samycharas/demoboard/DemoBoard.brd

## EAGLE design DemoBoard.brd (2022-02-07)

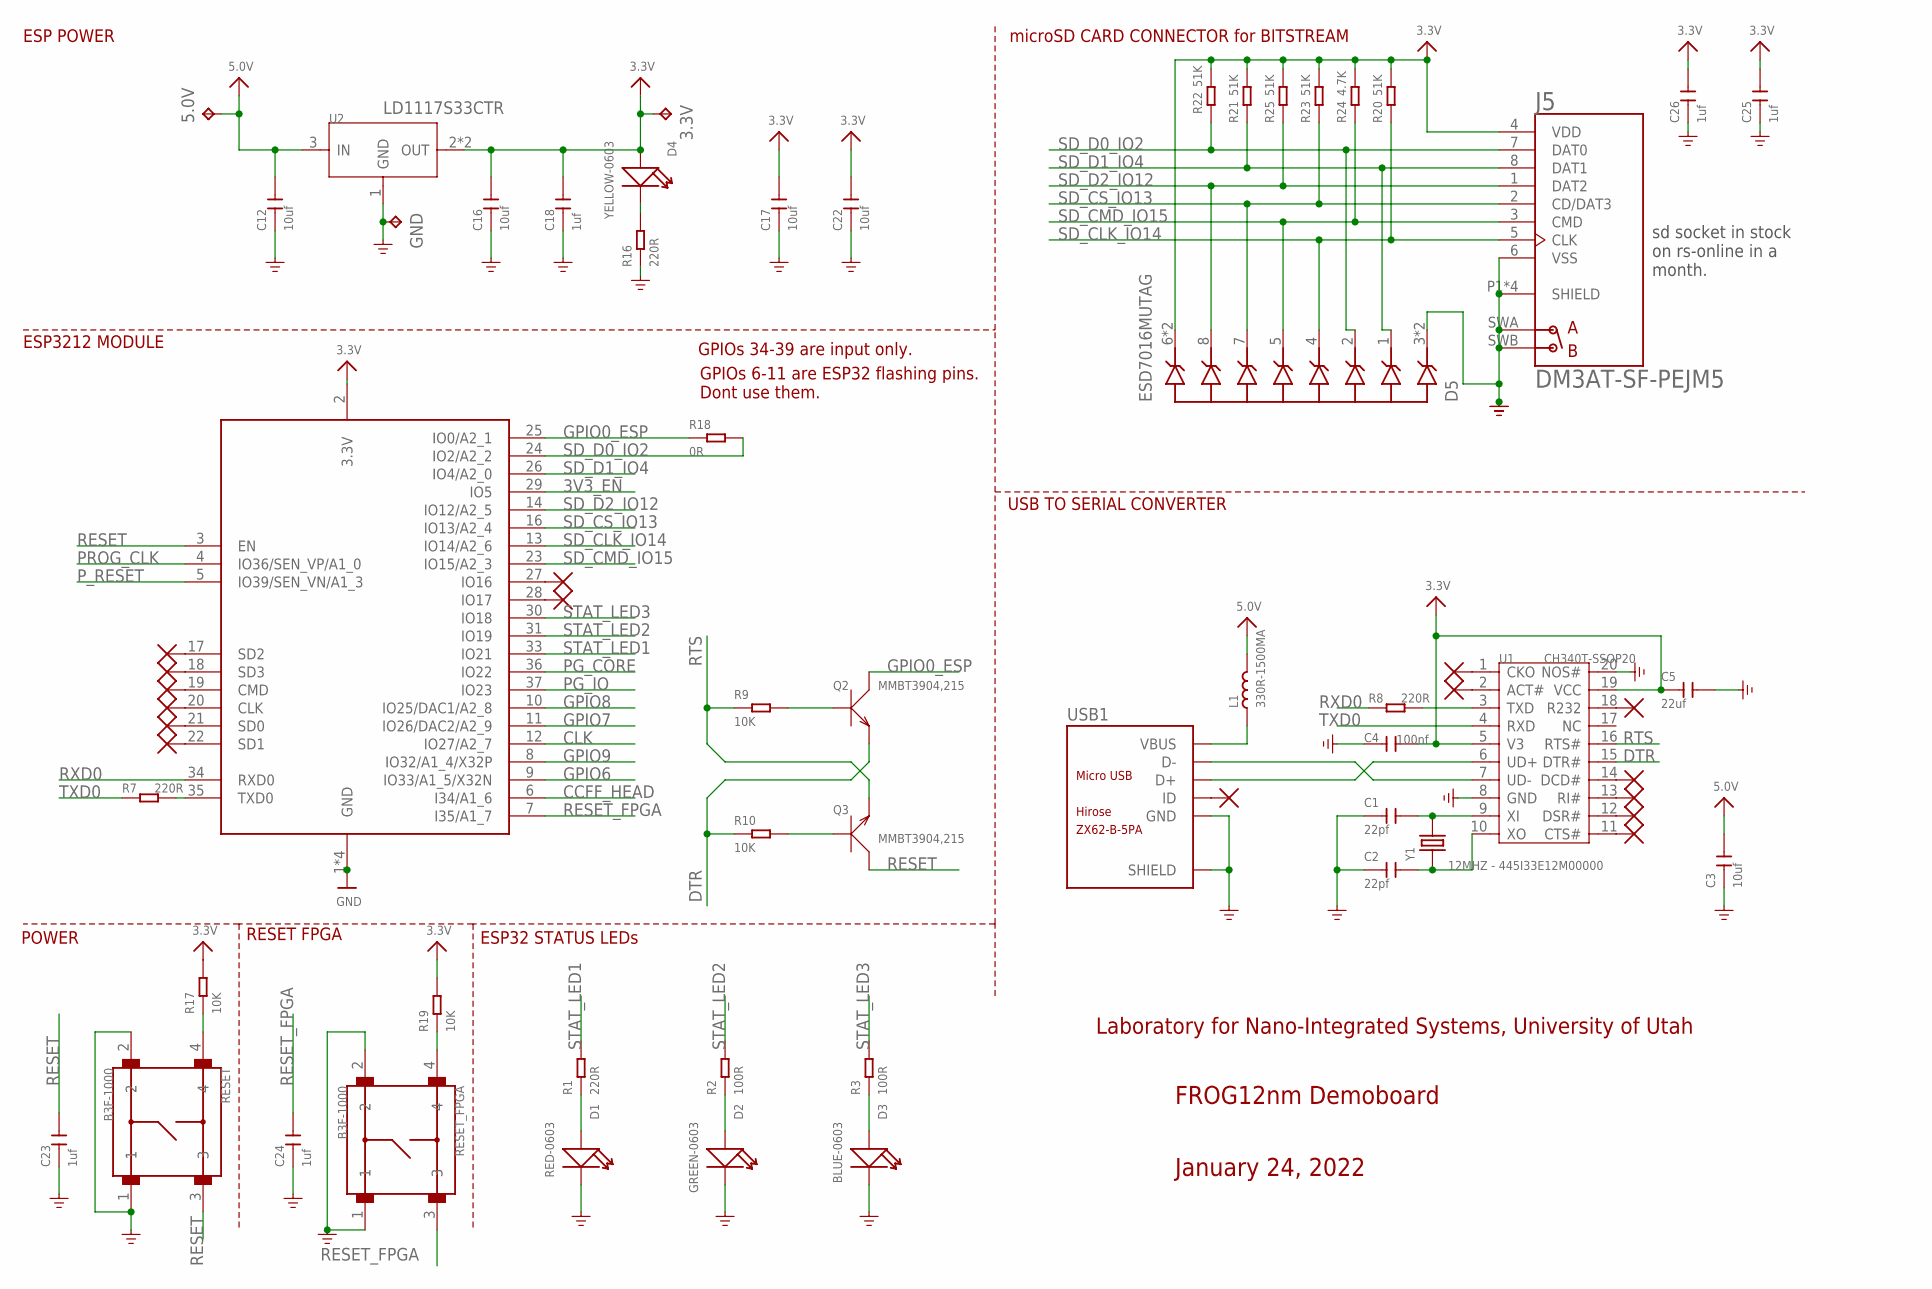
[picture p1: schematic DemoBoard.sch, sheet 1]

Parts:
3.3V, 5.0V: TPTP20SQ; TP20SQ
C1, C2: 22pf; C0603
C3, C12, C16, C17, C22: 10uf; C0603
C4: 100nf; C0603
C5: 22uf; C0805
C18, C23, C24, C25, C26: 1uf; C0603
D1: RED-0603; LED-0603
D2: GREEN-0603; LED-0603
D3: BLUE-0603; LED-0603
D4: YELLOW-0603; LED-0603
D5: ESD7016MUTAG; TVS_ESD7016MUTAG
GND: TPTP20SQ; TP20SQ
J5: DM3AT-SF-PEJM5; HRS_DM3AT-SF-PEJM5
L1: 330R-1500MA; L0805
Q2, Q3: MMBT3904,215; SOT-23
R1, R7, R8, R16: 220R; R0603
R2, R3: 100R; R0603
R9, R10, R17, R19: 10K; R0603
R18: 0R; R0603
R20, R21, R22, R23, R25: 51K; R0603
R24: 4.7K; R0603
RESET: B3F-1000; SW_B3F-1000
RESET_FPGA: B3F-1000; SW_B3F-1000
U1: CH340T-SSOP20; SSOP20-0.65-7.6X5.2MM
U2: PMIC-CJT1117-3.3(SOT223); SOT-223; MPN LD1117S33CTR
U3: ESP32_WROOM32_SKINNY; WROOM32_SKINNY
USB1: ZX62-B-5PA; MICRO-USB5+6P-SMD-0.65-AB
Y1: 12MHZ - 445I33E12M00000; X2-SMD-5.0X3.2X1.3MM

Connections:
3.3V: 3.3V.TP, C4.2, C5.1, C16.2, C17.2, C18.2, C22.2, C25.2, C26.2, D4.+, D5.6 (GND), D5.9 (GND), J5.4 (VDD), R17.2, R19.2, R20.2, R21.2, R22.2, R23.2, R24.2, R25.2, U1.5 (V3), U1.19 (VCC), U2.2 (OUT), U2.TER (OUT), U3.2 (3.3V); also elsewhere on the board
3V3_EN: U3.29 (IO5); also elsewhere on the board
5.0V: 5.0V.TP, C3.2, C12.2, L1.2, U2.3 (IN); also elsewhere on the board
CCFF_HEAD: U3.6 (I34/A1_6); also elsewhere on the board
CLK: U3.12 (IO27/A2_7); also elsewhere on the board
DTR: Q2.2 (E), R10.1, U1.15 (DTR#)
GND: C1.1, C2.1, C3.1, C4.1, C5.2, C12.1, C16.1, C17.1, C18.1, C22.1, C23.1, C24.1, C25.1, C26.1, D1.-, D2.-, D3.-, D5.3 (VBUS), D5.10 (VBUS), GND.TP, J5.6 (VSS), J5.P1 (SHIELD), J5.P2 (SHIELD), J5.P3 (SHIELD), J5.P4 (SHIELD), J5.SWA (A), J5.SWB (B), R16.1, RESET.1, RESET.2, RESET_FPGA.1, RESET_FPGA.2, U1.8 (GND), U1.20 (NOS#), U2.1 (GND), U3.1 (GND), U3.15 (GND), U3.38 (GND), U3.P$1 (GND), USB1.5 (GND), USB1.P1 (SHIELD), USB1.P2 (SHIELD), USB1.P3_1 (SHIELD), USB1.P3_2 (SHIELD), USB1.P3_3 (SHIELD), USB1.P4_1 (SHIELD), USB1.P4_2 (SHIELD), USB1.P4_3 (SHIELD), USB1.P5 (SHIELD), USB1.P6 (SHIELD); also elsewhere on the board
GPIO0_ESP: Q2.3 (C), R18.1, U3.25 (IO0/A2_1)
GPIO6: U3.9 (IO33/A1_5/X32N); also elsewhere on the board
GPIO7: U3.11 (IO26/DAC2/A2_9); also elsewhere on the board
GPIO8: U3.10 (IO25/DAC1/A2_8); also elsewhere on the board
GPIO9: U3.8 (IO32/A1_4/X32P); also elsewhere on the board
unnamed: D2.+, R2.1
unnamed: R17.1, RESET.4
unnamed: R19.1, RESET_FPGA.4
unnamed: D1.+, R1.1
unnamed: Q3.1 (B), R10.2
unnamed: Q2.1 (B), R9.2
unnamed: D3.+, R3.1
unnamed: D4.-, R16.2
unnamed: U1.7 (UD-), USB1.2 (D-)
unnamed: U1.6 (UD+), USB1.3 (D+)
unnamed: C1.2, U1.9 (XI), Y1.2
unnamed: C2.2, U1.10 (XO), Y1.1
unnamed: R8.2, U1.3 (TXD)
unnamed: R7.2, U3.35 (TXD0)
PG_CORE: U3.36 (IO22); also elsewhere on the board
PG_IO: U3.37 (IO23); also elsewhere on the board
PROG_CLK: U3.4 (IO36/SEN_VP/A1_0); also elsewhere on the board
P_RESET: U3.5 (IO39/SEN_VN/A1_3); also elsewhere on the board
RESET: C23.2, Q3.3 (C), RESET.3, U3.3 (EN)
RESET_FPGA: C24.2, RESET_FPGA.3, U3.7 (I35/A1_7); also elsewhere on the board
RTS: Q3.2 (E), R9.1, U1.16 (RTS#)
RXD0: R8.1, U3.34 (RXD0)
SD_CLK_IO14: D5.4 (I/O3), J5.5 (CLK), R20.1, U3.13 (IO14/A2_6)
SD_CMD_IO15: D5.5 (I/O4), J5.3 (CMD), R24.1, U3.23 (IO15/A2_3)
SD_CS_IO13: D5.7 (I/O5), J5.2 (CD/DAT3), R23.1, U3.16 (IO13/A2_4)
SD_D0_IO2: D5.2 (I/O2), J5.7 (DAT0), R18.2, R22.1, U3.24 (IO2/A2_2)
SD_D1_IO4: D5.1 (I/O1), J5.8 (DAT1), R21.1, U3.26 (IO4/A2_0)
SD_D2_IO12: D5.8 (I/O6), J5.1 (DAT2), R25.1, U3.14 (IO12/A2_5)
STAT_LED1: R1.2, U3.33 (IO21)
STAT_LED2: R2.2, U3.31 (IO19)
STAT_LED3: R3.2, U3.30 (IO18)
TXD0: R7.1, U1.4 (RXD)
VBUS: L1.1, USB1.1 (VBUS)

Notes on the sheet:
ESP POWER
RESET FPGA
USB TO SERIAL CONVERTER
ESP3212 MODULE
POWER
microSD CARD CONNECTOR for BITSTREAM
FROG12nm Demoboard
January 24, 2022
ESP32 STATUS LEDs
GPIOs 34-39 are input only.
Laboratory for Nano-Integrated Systems, University of Utah
GPIOs 6-11 are ESP32 flashing pins. Dont use them.
sd socket in stock on rs-online in a month.

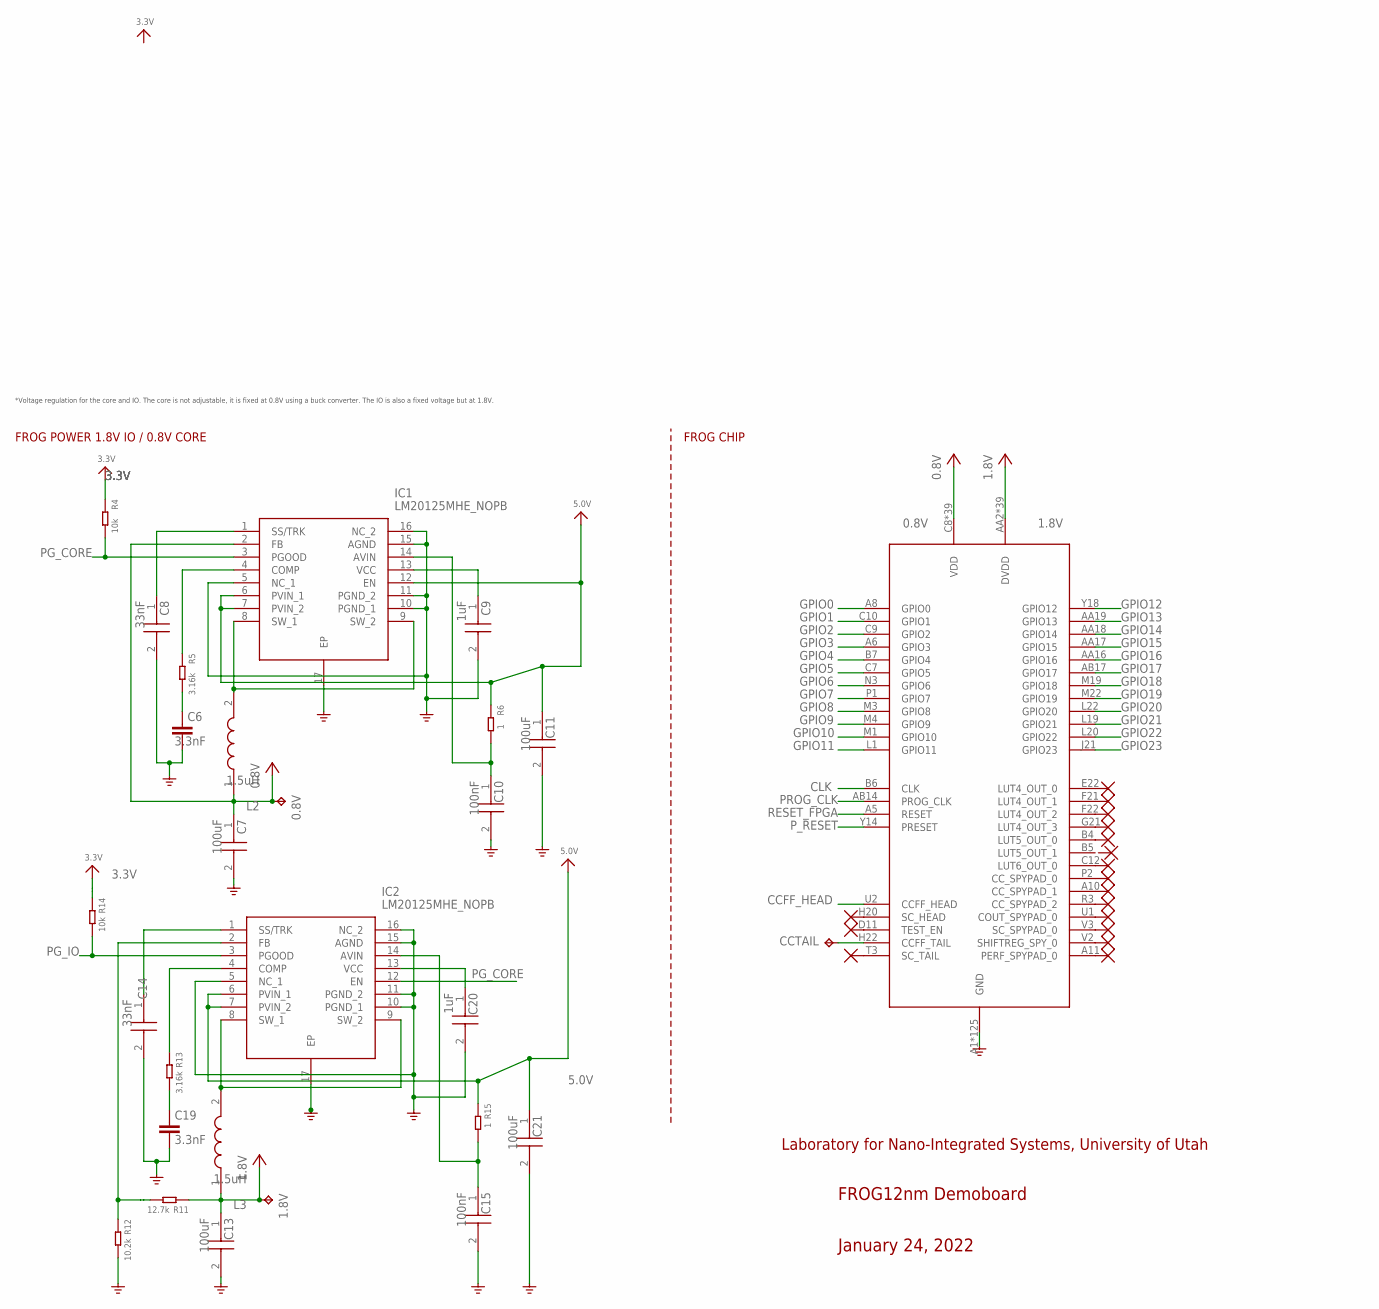
[picture p2: schematic DemoBoard.sch, sheet 2]

Parts:
0.8V, 1.8V: TPTP20SQ; TP20SQ
C6, C19: 3.3nF; CAPC1608X85
C7, C11, C13, C21: 100uF; CAPC3225X270N
C8, C14: 33nF; CAPC1608X97N
C9, C20: 1uF; CAPC1005X55N
C10, C15: 100nF; CAPC1005X55N
CCTAIL: TPPAD1-13; P1-13
IC1, IC2: LM20125MHE_NOPB; SOP65P640X120-17N
L2, L3: 1.5uH; INDPM7066X300N
R4, R14: 10k; R0603
R5, R13: 3.16k; R0603
R6, R15: 1; R0603
R11: 12.7k; R0603
R12: 10.2k; R0603
U4: FROG12NM; BGA484C100P22X22_2400X2400X220N

Connections:
0.8V: 0.8V.TP, C7.1, IC1.2 (FB), L2.1, U4.C8 (VDD), U4.D4 (VDD), U4.D5 (VDD), U4.D7 (VDD), U4.D8 (VDD), U4.D15 (VDD), U4.D16 (VDD), U4.D19 (VDD), U4.E19 (VDD), U4.H9 (VDD), U4.H10 (VDD), U4.H11 (VDD), U4.H12 (VDD), U4.H13 (VDD), U4.H14 (VDD), U4.J8 (VDD), U4.J15 (VDD), U4.K8 (VDD), U4.K15 (VDD), U4.L8 (VDD), U4.L15 (VDD), U4.M8 (VDD), U4.M15 (VDD), U4.N8 (VDD), U4.N15 (VDD), U4.P8 (VDD), U4.P15 (VDD), U4.R9 (VDD), U4.R10 (VDD), U4.R11 (VDD), U4.R12 (VDD), U4.R13 (VDD), U4.R14 (VDD), U4.W4 (VDD), U4.W5 (VDD), U4.W8 (VDD), U4.W15 (VDD), U4.W18 (VDD), U4.W19 (VDD)
1.8V: 1.8V.TP, C13.1, L3.1, R11.1, U4.AA2 (DVDD), U4.AA9 (DVDD), U4.AA14 (DVDD), U4.AA21 (DVDD), U4.AB5 (DVDD), U4.AB18 (DVDD), U4.B2 (DVDD), U4.B9 (DVDD), U4.B12 (DVDD), U4.B15 (DVDD), U4.B20 (DVDD), U4.B21 (DVDD), U4.C4 (DVDD), U4.C6 (DVDD), U4.C11 (DVDD), U4.C17 (DVDD), U4.D20 (DVDD), U4.E20 (DVDD), U4.F3 (DVDD), U4.F20 (DVDD), U4.G3 (DVDD), U4.G20 (DVDD), U4.H4 (DVDD), U4.H19 (DVDD), U4.N2 (DVDD), U4.N21 (DVDD), U4.R4 (DVDD), U4.R19 (DVDD), U4.R20 (DVDD), U4.T4 (DVDD), U4.U3 (DVDD), U4.U20 (DVDD), U4.U21 (DVDD), U4.V1 (DVDD), U4.V21 (DVDD), U4.V22 (DVDD), U4.Y6 (DVDD), U4.Y16 (DVDD), U4.Y17 (DVDD)
3.3V: R4.1, R14.1; also elsewhere on the board
5.0V: C11.1, C21.1, IC1.6 (PVIN_1), IC1.7 (PVIN_2), IC1.12 (EN), IC2.6 (PVIN_1), IC2.7 (PVIN_2), R6.1, R15.1; also elsewhere on the board
CCFF_HEAD: U4.U2 (CCFF_HEAD); also elsewhere on the board
CLK: U4.B6 (CLK); also elsewhere on the board
GND: C6.2, C7.2, C8.2, C9.2, C10.2, C11.2, C13.2, C14.2, C15.2, C19.2, C20.2, C21.2, IC1.5 (NC_1), IC1.10 (PGND_1), IC1.11 (PGND_2), IC1.15 (AGND), IC1.16 (NC_2), IC1.17 (EP), IC2.5 (NC_1), IC2.10 (PGND_1), IC2.11 (PGND_2), IC2.15 (AGND), IC2.16 (NC_2), IC2.17 (EP), R12.2, U4.A1 (GND), U4.A4 (GND), U4.A9 (GND), U4.A12 (GND), U4.A15 (GND), U4.A19 (GND), U4.A22 (GND), U4.AA3 (GND), U4.AA10 (GND), U4.AA13 (GND), U4.AA20 (GND), U4.AB1 (GND), U4.AB4 (GND), U4.AB7 (GND), U4.AB10 (GND), U4.AB13 (GND), U4.AB16 (GND), U4.AB19 (GND), U4.AB22 (GND), U4.B3 (GND), U4.B10 (GND), U4.B11 (GND), U4.B13 (GND), U4.B14 (GND), U4.C2 (GND), U4.C3 (GND), U4.C13 (GND), U4.C14 (GND), U4.C20 (GND), U4.C21 (GND), U4.D1 (GND), U4.D3 (GND), U4.D6 (GND), U4.D9 (GND), U4.D10 (GND), U4.D14 (GND), U4.D17 (GND), U4.D18 (GND), U4.D21 (GND), U4.D22 (GND), U4.E4 (GND), U4.F4 (GND), U4.F19 (GND), U4.G1 (GND), U4.G4 (GND), U4.G19 (GND), U4.G22 (GND), U4.H8 (GND), U4.H15 (GND), U4.J4 (GND), U4.J9 (GND), U4.J10 (GND), U4.J11 (GND), U4.J12 (GND), U4.J13 (GND), U4.J14 (GND), U4.K1 (GND), U4.K4 (GND), U4.K9 (GND), U4.K10 (GND), U4.K11 (GND), U4.K12 (GND), U4.K13 (GND), U4.K14 (GND), U4.K19 (GND), U4.K22 (GND), U4.L2 (GND), U4.L4 (GND), U4.L9 (GND), U4.L10 (GND), U4.L11 (GND), U4.L12 (GND), U4.L13 (GND), U4.L14 (GND), U4.L21 (GND), U4.M2 (GND), U4.M9 (GND), U4.M10 (GND), U4.M11 (GND), U4.M12 (GND), U4.M13 (GND), U4.M14 (GND), U4.M20 (GND), U4.M21 (GND), U4.N1 (GND), U4.N4 (GND), U4.N9 (GND), U4.N10 (GND), U4.N11 (GND), U4.N12 (GND), U4.N13 (GND), U4.N14 (GND), U4.N19 (GND), U4.N22 (GND), U4.P9 (GND), U4.P10 (GND), U4.P11 (GND), U4.P12 (GND), U4.P13 (GND), U4.P14 (GND), U4.R2 (GND), U4.R8 (GND), U4.R15 (GND), U4.T1 (GND), U4.T2 (GND), U4.T19 (GND), U4.T22 (GND), U4.U4 (GND), U4.U19 (GND), U4.V4 (GND), U4.V19 (GND), U4.W1 (GND), U4.W2 (GND), U4.W6 (GND), U4.W7 (GND), U4.W10 (GND), U4.W13 (GND), U4.W16 (GND), U4.W17 (GND), U4.W22 (GND), U4.Y2 (GND), U4.Y3 (GND), U4.Y10 (GND), U4.Y13 (GND), U4.Y20 (GND); also elsewhere on the board
GPIO0: U4.A8 (GPIO0); also elsewhere on the board
GPIO1: U4.C10 (GPIO1); also elsewhere on the board
GPIO2: U4.C9 (GPIO2); also elsewhere on the board
GPIO3: U4.A6 (GPIO3); also elsewhere on the board
GPIO4: U4.B7 (GPIO4); also elsewhere on the board
GPIO5: U4.C7 (GPIO5); also elsewhere on the board
GPIO6: U4.N3 (GPIO6); also elsewhere on the board
GPIO7: U4.P1 (GPIO7); also elsewhere on the board
GPIO8: U4.M3 (GPIO8); also elsewhere on the board
GPIO9: U4.M4 (GPIO9); also elsewhere on the board
GPIO10: U4.M1 (GPIO10); also elsewhere on the board
GPIO11: U4.L1 (GPIO11); also elsewhere on the board
GPIO12: U4.Y18 (GPIO12); also elsewhere on the board
GPIO13: U4.AA19 (GPIO13); also elsewhere on the board
GPIO14: U4.AA18 (GPIO14); also elsewhere on the board
GPIO15: U4.AA17 (GPIO15); also elsewhere on the board
GPIO16: U4.AA16 (GPIO16); also elsewhere on the board
GPIO17: U4.AB17 (GPIO17); also elsewhere on the board
GPIO18: U4.M19 (GPIO18); also elsewhere on the board
GPIO19: U4.M22 (GPIO19); also elsewhere on the board
GPIO20: U4.L22 (GPIO20); also elsewhere on the board
GPIO21: U4.L19 (GPIO21); also elsewhere on the board
GPIO22: U4.L20 (GPIO22); also elsewhere on the board
GPIO23: U4.J21 (GPIO23); also elsewhere on the board
unnamed: IC1.4 (COMP), R5.1
unnamed: C6.1, R5.2
unnamed: C9.1, IC1.13 (VCC)
unnamed: C8.1, IC1.1 (SS/TRK)
unnamed: IC1.8 (SW_1), IC1.9 (SW_2), L2.2
unnamed: CCTAIL.TP, U4.H22 (CCFF_TAIL)
unnamed: C10.1, IC1.14 (AVIN), R6.2
unnamed: IC2.4 (COMP), R13.1
unnamed: C19.1, R13.2
unnamed: C20.1, IC2.13 (VCC)
unnamed: C14.1, IC2.1 (SS/TRK)
unnamed: IC2.8 (SW_1), IC2.9 (SW_2), L3.2
unnamed: C15.1, IC2.14 (AVIN), R15.2
PG_CORE: IC1.3 (PGOOD), IC2.12 (EN), R4.2; also elsewhere on the board
PG_IO: IC2.3 (PGOOD), R14.2; also elsewhere on the board
PROG_CLK: U4.AB14 (PROG_CLK); also elsewhere on the board
P_RESET: U4.Y14 (PRESET); also elsewhere on the board
RESET_FPGA: U4.A5 (RESET); also elsewhere on the board
VDD_CORE: IC2.2 (FB), R11.2, R12.1

Notes on the sheet:
FROG12nm Demoboard
January 24, 2022
Laboratory for Nano-Integrated Systems, University of Utah
*Voltage regulation for the core and IO. The core is not adjustable, it is fixed at 0.8V using a buck converter. The IO is also a fixed voltage but at 1.8V.
FROG POWER 1.8V IO / 0.8V CORE
FROG CHIP

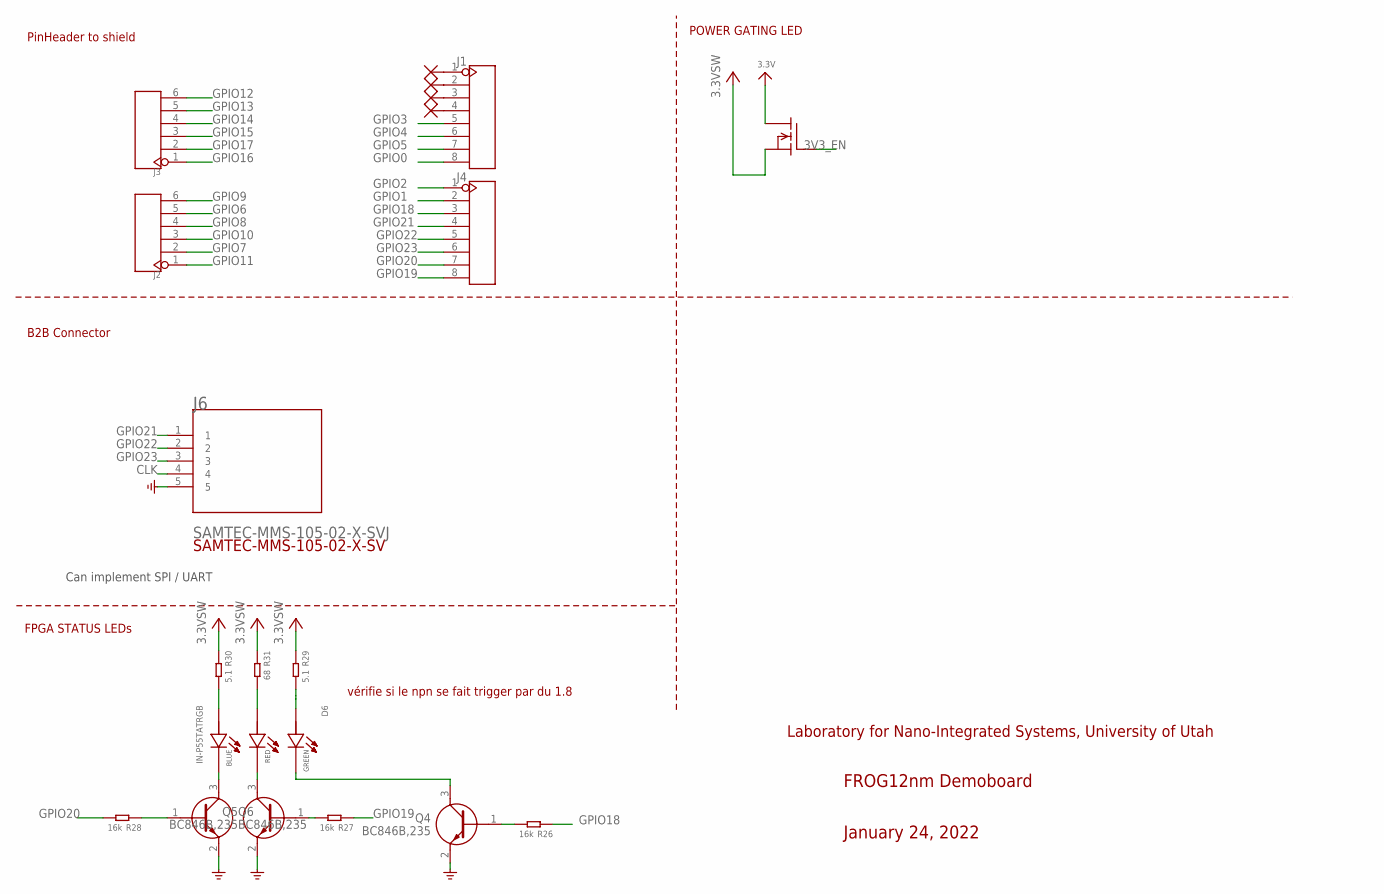
[picture p3: schematic DemoBoard.sch, sheet 3]

Parts:
D6: IN-P55TATRGB; LED_IN-P55TATRGB
J1, J4: HEADER-8P-2.54; 8P-2.54
J2, J3: HEADER-6P-55/35MIL; 6P-2.54-55/35MIL
J6: SAMTEC-MMS-105-02-X-SVJ; SAMTEC-MMS-105-02-X-SV
Q1: IRLML0030TRPBF; SOT23
Q4, Q5, Q6: BC846B,235; SOT95P230X110-3N
R26, R27, R28: 16k; R0603
R29, R30: 5.1; R0603
R31: 68; R0603

Connections:
3.3V: Q1.3 (D); also elsewhere on the board
3.3VSW: Q1.2 (S), R29.1, R30.1, R31.1
3V3_EN: Q1.1 (G); also elsewhere on the board
CLK: J6.4; also elsewhere on the board
GND: J6.5, Q4.2 (E), Q5.2 (E), Q6.2 (E); also elsewhere on the board
GPIO0: J1.8; also elsewhere on the board
GPIO1: J4.2; also elsewhere on the board
GPIO2: J4.1; also elsewhere on the board
GPIO3: J1.5; also elsewhere on the board
GPIO4: J1.6; also elsewhere on the board
GPIO5: J1.7; also elsewhere on the board
GPIO6: J2.5; also elsewhere on the board
GPIO7: J2.2; also elsewhere on the board
GPIO8: J2.4; also elsewhere on the board
GPIO9: J2.6; also elsewhere on the board
GPIO10: J2.3; also elsewhere on the board
GPIO11: J2.1; also elsewhere on the board
GPIO12: J3.6; also elsewhere on the board
GPIO13: J3.5; also elsewhere on the board
GPIO14: J3.4; also elsewhere on the board
GPIO15: J3.3; also elsewhere on the board
GPIO16: J3.1; also elsewhere on the board
GPIO17: J3.2; also elsewhere on the board
GPIO18: J4.3, R26.1; also elsewhere on the board
GPIO19: J4.8, R27.1; also elsewhere on the board
GPIO20: J4.7, R28.2; also elsewhere on the board
GPIO21: J4.4, J6.1; also elsewhere on the board
GPIO22: J4.5, J6.2; also elsewhere on the board
GPIO23: J4.6, J6.3; also elsewhere on the board
unnamed: D6.1 (B_C), Q6.3 (C)
unnamed: Q5.1 (B), R27.2
unnamed: D6.2 (R_C), Q5.3 (C)
unnamed: D6.3 (G_C), Q4.3 (C)
unnamed: Q6.1 (B), R28.1
unnamed: Q4.1 (B), R26.2
unnamed: D6.5 (R_A), R31.2
VCC2: D6.4 (G_A), D6.6 (B_A), R29.2, R30.2

Notes on the sheet:
FROG12nm Demoboard
January 24, 2022
Laboratory for Nano-Integrated Systems, University of Utah
B2B Connector
Can implement SPI / UART
PinHeader to shield
FPGA STATUS LEDs
vérifie si le npn se fait trigger par du 1.8
POWER GATING LED

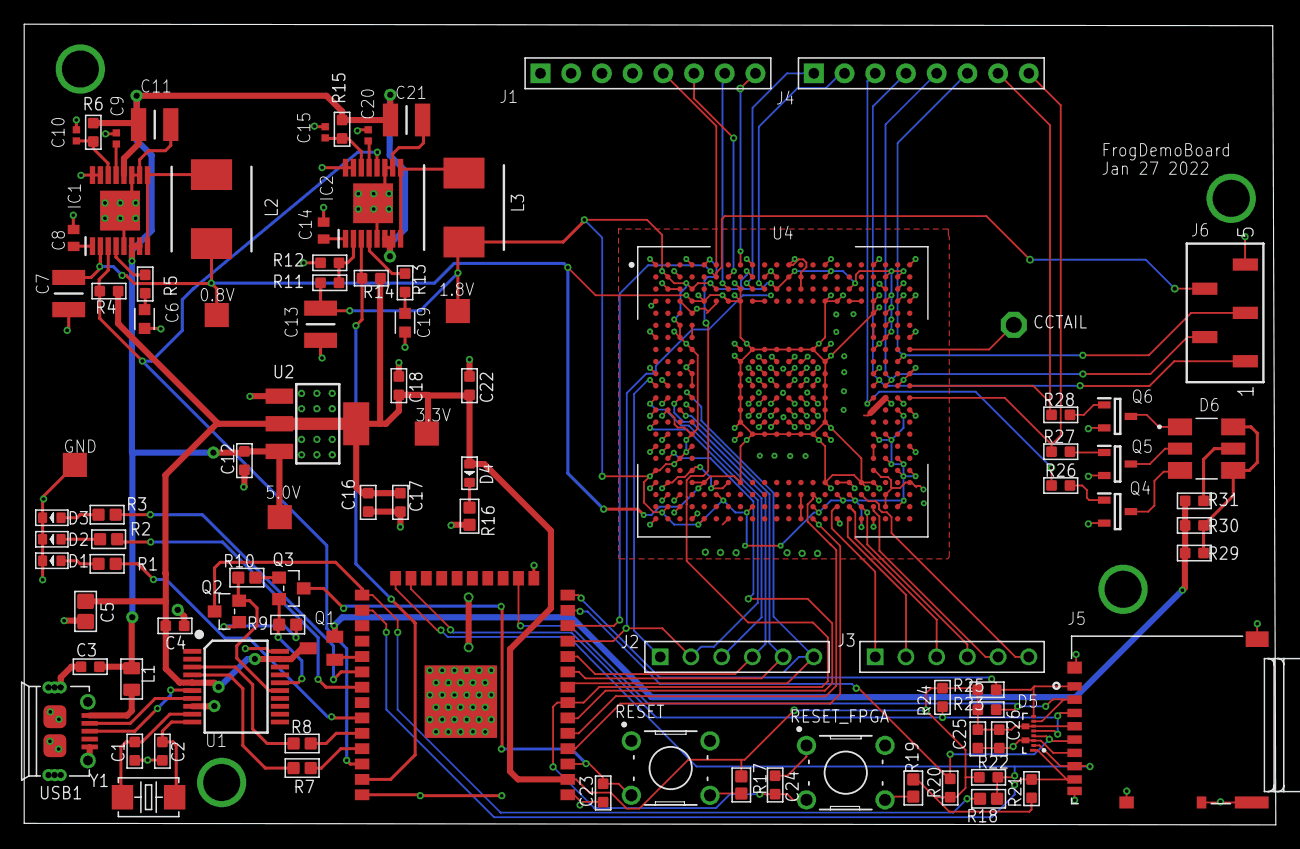
[picture p4: board DemoBoard.brd from above]

Board: 2 copper layers, 103.5 x 66.2 mm, 94 parts (0 on the bottom side), 90 nets.
