samycharas/demoboard/project/DemoBoard.brd

## EAGLE design project/DemoBoard.brd (2020-08-27, an earlier design)

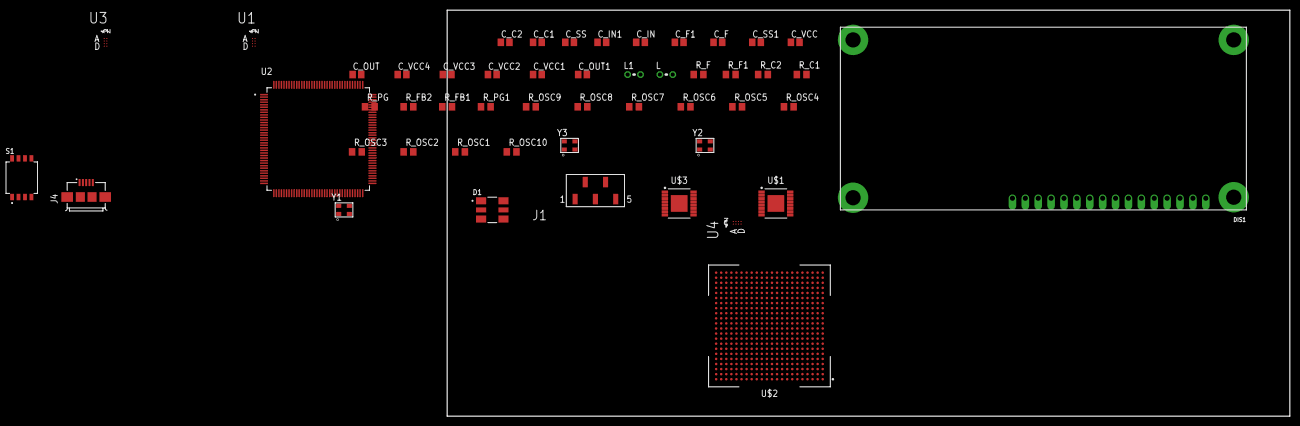
[picture p5: board project/DemoBoard.brd from above]

Board: 2 copper layers, 166.0 x 80.0 mm, 50 parts (0 on the bottom side), 46 nets, no tracks yet.

Parts:
C_C1, C_C2: 3.3nF; C0805
C_F, C_F1: 100nF; C0805
C_IN, C_IN1: 100uF; C0805
C_OUT, C_OUT1: 100uF; C0805
C_SS, C_SS1: 33nF; C0805
C_VCC, C_VCC1, C_VCC2, C_VCC3, C_VCC4: 1uF; C0805
D1: IN-P55TATRGB; LED_IN-P55TATRGB
DIS1: HD44780_16026_16X2_BYG_5V; 16026-16X2
J1: SAMTEC-MMS-105-02-X-SVJ; SAMTEC-MMS-105-02-X-SV
J4: 10104111-0001LF; FRAMATOME_10104111-0001LF
L, L1: 1.5uH; 0204V
R_C1, R_C2: 3.16K; R0805
R_F, R_F1: 1; R0805
R_FB1: 12.7k; R0805
R_FB2: 10.2k; R0805
R_OSC1, R_OSC2, R_OSC3: 1k; R0805
R_OSC4, R_OSC6: 280; R0805
R_OSC5, R_OSC7, R_OSC8, R_OSC9, R_OSC10: 220; R0805
R_PG, R_PG1: 10K; R0805
S1: 1571983-4; SW_1571983-4
U1, U3, U4: SN74LVC2T45YZPR; BGA8C50P2X4_190X90X50
U2: STM32F207ZGT6; QFP50P2200X2200X160-144N
U$1, U$3: LM20125/LM20125Q; SOP65P640X120-17T330L
U$2: BGA352; BGA484C100P22X22_2400X2400X220N
Y1, Y2, Y3: SIT1602BI-23-18E-33.333300G; OSCDFN320X250X80-4N

Connections:
5V_EXT: C_IN.1, C_IN1.1, R_F.2, R_F1.2, R_PG.2, R_PG1.2, U$1.6, U$1.7, U$1.12, U$3.6, U$3.7
CLK: J1.4, U$2.B6
DB7: DIS1.P$14, U4.B1
GND: C_C1.2, C_C2.2, C_F.2, C_F1.2, C_IN.2, C_IN1.2, C_OUT.2, C_OUT1.2, C_SS.2, C_SS1.2, C_VCC.2, C_VCC1.2, C_VCC2.2, C_VCC3.2, C_VCC4.2, DIS1.P$1, DIS1.P$16, J4.5, R_FB2.2, U1.D1, U1.D2, U3.D1, U3.D2, U4.D1, U4.D2, U$1.5, U$1.10, U$1.11, U$1.15, U$1.16, U$1.17, U$2.A1, U$2.A4, U$2.A9, U$2.A12, U$2.A15, U$2.A19, U$2.A22, U$2.AA3, U$2.AA10, U$2.AA13, U$2.AA20, U$2.AB1, U$2.AB4, U$2.AB7, U$2.AB10, U$2.AB13, U$2.AB16, U$2.AB19, U$2.AB22, U$2.B3, U$2.B10, U$2.B11, U$2.B13, U$2.B14, U$2.C2, U$2.C3, U$2.C13, U$2.C14, U$2.C20, U$2.C21, U$2.D1, U$2.D3, U$2.D6, U$2.D9, U$2.D10, U$2.D14, U$2.D17, U$2.D18, U$2.D21, U$2.D22, U$2.E4, U$2.F4, U$2.F19, U$2.G1, U$2.G4, U$2.G19, U$2.G22, U$2.H8, U$2.H15, U$2.J4, U$2.J9, U$2.J10, U$2.J11, U$2.J12, U$2.J13, U$2.J14, U$2.K1, U$2.K4, U$2.K9, U$2.K10, U$2.K11, U$2.K12, U$2.K13, U$2.K14, U$2.K19, U$2.K22, U$2.L2, U$2.L4, U$2.L9, U$2.L10, U$2.L11, U$2.L12, U$2.L13, U$2.L14, U$2.L21, U$2.M2, U$2.M9, U$2.M10, U$2.M11, U$2.M12, U$2.M13, U$2.M14, U$2.M20, U$2.M21, U$2.N1, U$2.N4, U$2.N9, U$2.N10, U$2.N11, U$2.N12, U$2.N13, U$2.N14, U$2.N19, U$2.N22, U$2.P9, U$2.P10, U$2.P11, U$2.P12, U$2.P13, U$2.P14, U$2.R2, U$2.R8, U$2.R15, U$2.T1, U$2.T2, U$2.T19, U$2.T22, U$2.U4, U$2.U19, U$2.V4, U$2.V19, U$2.W1, U$2.W2, U$2.W6, U$2.W7, U$2.W10, U$2.W13, U$2.W16, U$2.W17, U$2.W22, U$2.Y2, U$2.Y3, U$2.Y10, U$2.Y13, U$2.Y20, U$3.5, U$3.10, U$3.11, U$3.15, U$3.16, U$3.17, Y1.2, Y2.2, Y3.2
GPIO8: R_OSC5.2, U$2.M3
GPIO9: R_OSC4.2, U$2.M4
GPIO10: R_OSC6.2, U$2.M1
GPIO12: U4.B2, U$2.Y18
GPIO20: J1.1, U$2.L22
GPIO21: J1.2, U$2.L19
GPIO22: J1.3, U$2.L20
unnamed: R_C2.2, U$3.4
unnamed: C_SS.1, U$1.1
unnamed: R_C1.2, U$1.4
unnamed: C_C1.1, R_C1.1
unnamed: C_VCC.1, U$1.13
unnamed: C_C2.1, R_C2.1
unnamed: L.2, U$1.8, U$1.9
unnamed: C_VCC1.1, U$3.13
unnamed: C_SS1.1, U$3.1
unnamed: L1.2, U$3.8, U$3.9
unnamed: C_F1.1, R_F1.1, U$3.14
unnamed: C_F.1, R_F.1, U$1.14
unnamed: S1.2, Y1.3
unnamed: C_VCC2.1, R_OSC1.2, Y1.4
unnamed: R_OSC1.1, Y1.1
unnamed: S1.3, Y2.3
unnamed: R_OSC2.2, Y2.4
unnamed: R_OSC2.1, Y2.1
unnamed: S1.4, Y3.3
unnamed: R_OSC3.2, Y3.4
unnamed: R_OSC3.1, Y3.1
unnamed: S1.2-1, S1.3-1, S1.4-1
unnamed: D1.1, R_OSC4.1
unnamed: D1.2, R_OSC5.1
unnamed: D1.3, R_OSC6.1
PG_CORE: R_PG.1, U$1.3, U$3.12
PG_IO: R_PG1.1, U$3.3
S: J4.6, J4.7, J4.8, J4.9
VCC33: D1.4, D1.6, R_OSC7.2, R_OSC10.2
VCCA: U1.A1, U3.A1, U4.A1
VCCB: U1.A2, U3.A2, U4.A2
VDD: U2.17, U2.30, U2.39, U2.52, U2.62, U2.72, U2.84, U2.95, U2.108, U2.121, U2.131, U2.144
VDD_CORE: C_OUT.1, L.1, R_FB1.2, R_FB2.1, U$1.2, U$2.C8, U$2.D4, U$2.D5, U$2.D7, U$2.D8, U$2.D15, U$2.D16, U$2.D19, U$2.E19, U$2.H9, U$2.H10, U$2.H11, U$2.H12, U$2.H13, U$2.H14, U$2.J8, U$2.J15, U$2.K8, U$2.K15, U$2.L8, U$2.L15, U$2.M8, U$2.M15, U$2.N8, U$2.N15, U$2.P8, U$2.P15, U$2.R9, U$2.R10, U$2.R11, U$2.R12, U$2.R13, U$2.R14, U$2.W4, U$2.W5, U$2.W8, U$2.W15, U$2.W18, U$2.W19, U$3.2
VDD_IO: C_OUT1.1, D1.5, L1.1, R_FB1.1, U$2.AA2, U$2.AA9, U$2.AA14, U$2.AA21, U$2.AB5, U$2.AB18, U$2.B2, U$2.B9, U$2.B12, U$2.B15, U$2.B20, U$2.B21, U$2.C4, U$2.C6, U$2.C11, U$2.C17, U$2.D20, U$2.E20, U$2.F3, U$2.F20, U$2.G3, U$2.G20, U$2.H4, U$2.H19, U$2.K2, U$2.K21, U$2.N2, U$2.N21, U$2.R4, U$2.R19, U$2.R20, U$2.T4, U$2.U3, U$2.U20, U$2.U21, U$2.V1, U$2.V21, U$2.V22, U$2.Y6, U$2.Y16, U$2.Y17
VSS: U2.16, U2.38, U2.51, U2.61, U2.83, U2.94, U2.107, U2.120, U2.130
