samycharas/demoboard/(commit log)

2020-08-26 Adding BGA lib with footprint
2022-01-27 Demoboard routing with BGA left
    [DemoBoard.brd]
2022-02-07 Finalize routing, DRC Clean
    [DemoBoard.brd, DemoBoard.sch]
